emmie/placa_desarrollo_efm32/Placa ARM.kicad_pcb

## KiCad design Placa ARM.kicad_pcb (2020-09-28)

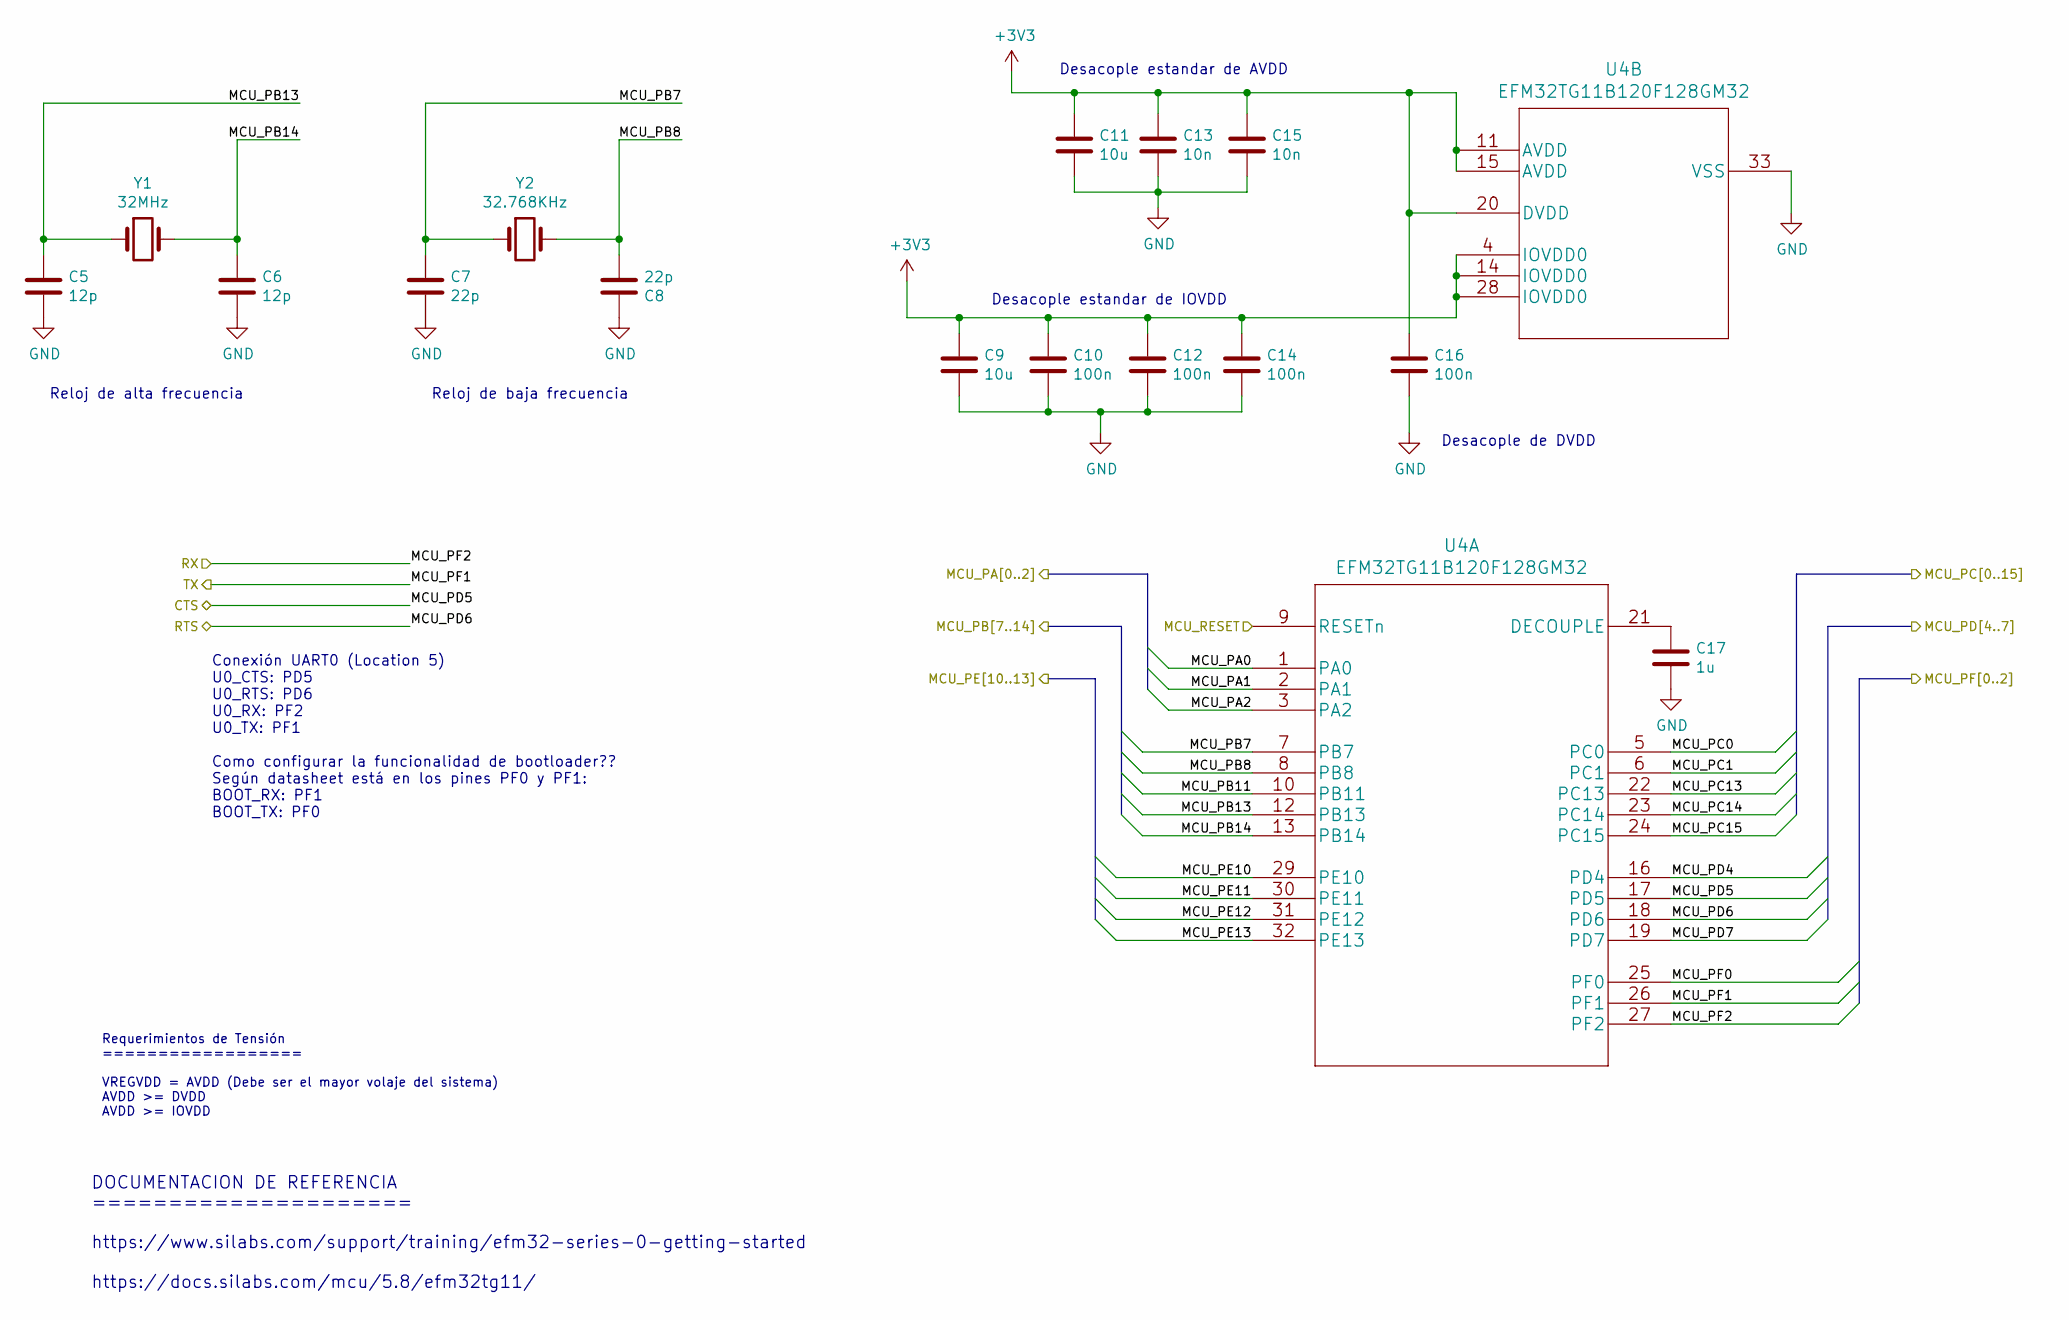
[picture p1: schematic Microcontrolador.sch, Placa de Desarrollo EFM32 - MCU ARM]

Parts:
C5, C6: 12p; C_0805_2012Metric_Pad1.15x1.40mm_HandSolder
C7, C8: 22p; C_0805_2012Metric_Pad1.15x1.40mm_HandSolder
C9, C11: 10u; C_1206_3216Metric_Pad1.42x1.75mm_HandSolder
C10, C12, C14, C16: 100n; C_1206_3216Metric_Pad1.42x1.75mm_HandSolder
C13, C15: 10n; C_1206_3216Metric_Pad1.42x1.75mm_HandSolder
C17: 1u; C_1206_3216Metric_Pad1.42x1.75mm_HandSolder
U4: EFM32TG11B120F128GM32
Y1: 32MHz; Crystal_SMD_ECS_CSM3X-2Pin_7.6x4.1mm
Y2: 32.768KHz; Crystal_AT310_D3.0mm_L10.0mm_Horizontal

Connections:
/IU5: U4.9 (RESETn); also elsewhere on the board
/IU6: U4.26 (PF1); also elsewhere on the board
/IU7: U4.27 (PF2); also elsewhere on the board
/IU8: U4.17 (PD5); also elsewhere on the board
/IU9: U4.18 (PD6); also elsewhere on the board
/Interfaz de Usuario/MCU_PA0: U4.1 (PA0); also elsewhere on the board
/Interfaz de Usuario/MCU_PA1: U4.2 (PA1); also elsewhere on the board
/Interfaz de Usuario/MCU_PA2: U4.3 (PA2); also elsewhere on the board
/Interfaz de Usuario/MCU_PB11: U4.10 (PB11); also elsewhere on the board
/Interfaz de Usuario/MCU_PC0: U4.5 (PC0); also elsewhere on the board
/Interfaz de Usuario/MCU_PC1: U4.6 (PC1); also elsewhere on the board
/Interfaz de Usuario/MCU_PC13: U4.22 (PC13); also elsewhere on the board
/Interfaz de Usuario/MCU_PC14: U4.23 (PC14); also elsewhere on the board
/Interfaz de Usuario/MCU_PC15: U4.24 (PC15); also elsewhere on the board
/Interfaz de Usuario/MCU_PD4: U4.16 (PD4); also elsewhere on the board
/Interfaz de Usuario/MCU_PD7: U4.19 (PD7); also elsewhere on the board
/Interfaz de Usuario/MCU_PE10: U4.29 (PE10); also elsewhere on the board
/Interfaz de Usuario/MCU_PE11: U4.30 (PE11); also elsewhere on the board
/Interfaz de Usuario/MCU_PE12: U4.31 (PE12); also elsewhere on the board
/Interfaz de Usuario/MCU_PE13: U4.32 (PE13); also elsewhere on the board
/Interfaz de Usuario/MCU_PF0: U4.25 (PF0); also elsewhere on the board
/Microcontrolador/MCU_PB7: C7.1, U4.7 (PB7), Y2.1
/Microcontrolador/MCU_PB13: C5.1, U4.12 (PB13), Y1.1
/Microcontrolador/MCU_PB14: C6.1, U4.13 (PB14), Y1.2
unnamed: C17.1, U4.21 (DECOUPLE)

Notes on the sheet:
Desacople estandar de AVDD
Desacople estandar de IOVDD
Reloj de baja frecuencia
Reloj de alta frecuencia
Desacople de DVDD
Conexión UART0 (Location 5) U0_CTS: PD5 U0_RTS: PD6 U0_RX: PF2 U0_TX: PF1 Como configurar la funcionalidad de bootloader?? Según datasheet está en los pines PF0 y PF1: BOOT_RX: PF1 BOOT_TX: PF0
Requerimientos de Tensión ================== VREGVDD = AVDD (Debe ser el mayor volaje del sistema) AVDD >= DVDD AVDD >= IOVDD
DOCUMENTACION DE REFERENCIA ===================== https://www.silabs.com/support/training/efm32-series-0-getting-started https://docs.silabs.com/mcu/5.8/efm32tg11/

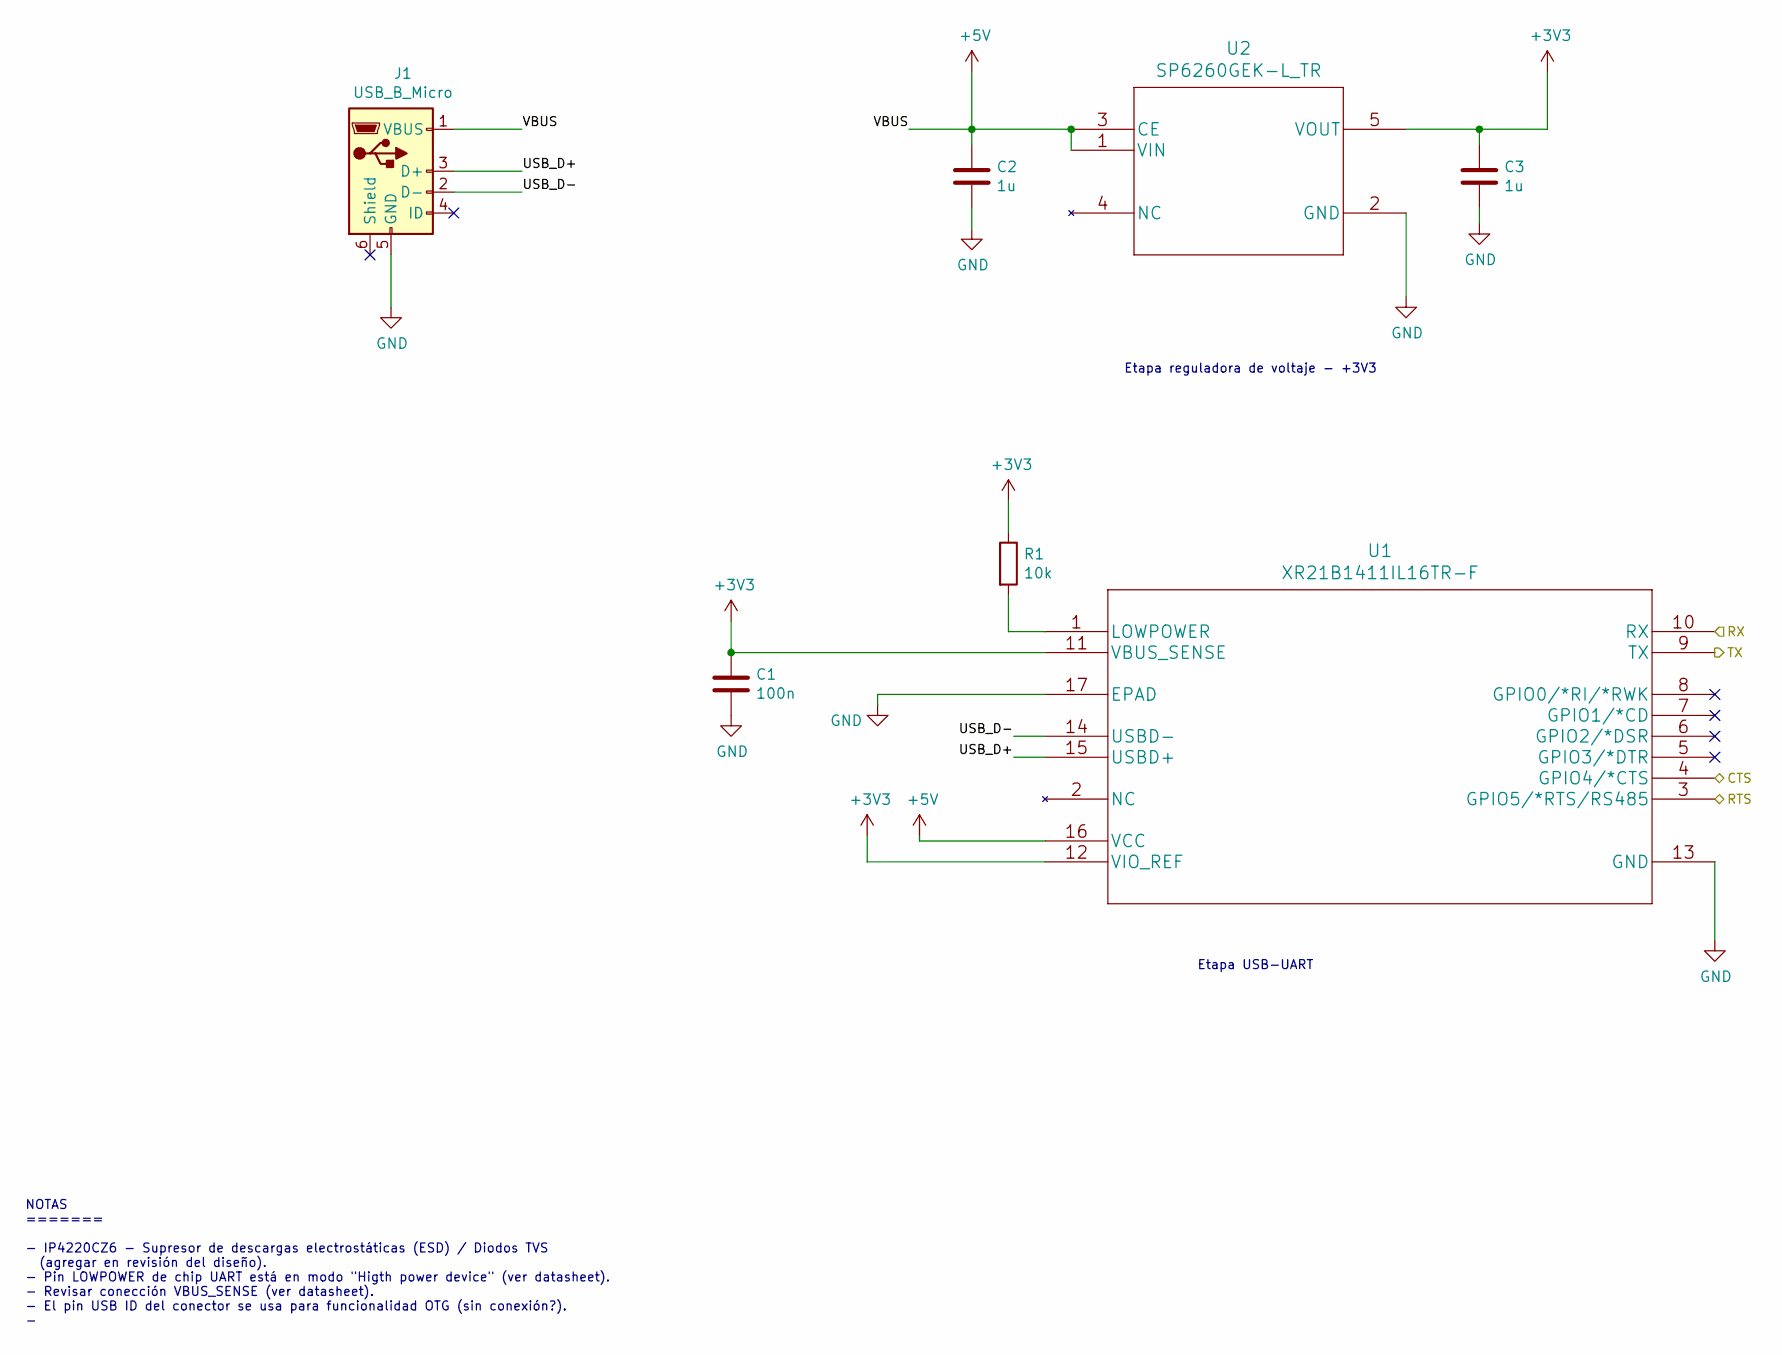
[picture p2: schematic Fuente de Poder.sch, Placa de Desarrollo EFM32 - MCU ARM]

Parts:
C1: 100n; C_1206_3216Metric_Pad1.42x1.75mm_HandSolder
C2, C3: 1u; C_1206_3216Metric_Pad1.42x1.75mm_HandSolder
J1: USB_B_Micro; USB_Micro-B_Molex_47346-0001
R1: 10k; R_1206_3216Metric_Pad1.42x1.75mm_HandSolder
U1: XR21B1411IL16TR-F
U2: SP6260GEK-L_TR; SP6260GEKLTR

Connections:
+5V: C2.1, J1.1 (VBUS), U1.16 (VCC), U2.1 (VIN), U2.3 (CE); also elsewhere on the board
/Fuente de Poder/USB_D+: J1.3 (D+), U1.15 (USBD+)
/Fuente de Poder/USB_D-: J1.2 (D-), U1.14 (USBD-)
/IU6: U1.10 (RX); also elsewhere on the board
/IU7: U1.9 (TX); also elsewhere on the board
/IU8: U1.4 (GPIO4/*CTS); also elsewhere on the board
/IU9: U1.3 (GPIO5/*RTS/RS485); also elsewhere on the board
unnamed: R1.2, U1.1 (LOWPOWER)

Notes on the sheet:
Etapa reguladora de voltaje - +3V3
NOTAS ======= - IP4220CZ6 - Supresor de descargas electrostáticas (ESD) / Diodos TVS (agregar en revisión del diseño). - Pin LOWPOWER de chip UART está en modo "Higth power device" (ver datasheet). - Revisar conección VBUS_SENSE (ver datasheet). - El pin USB ID del conector se usa para funcionalida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
Etapa USB-UART

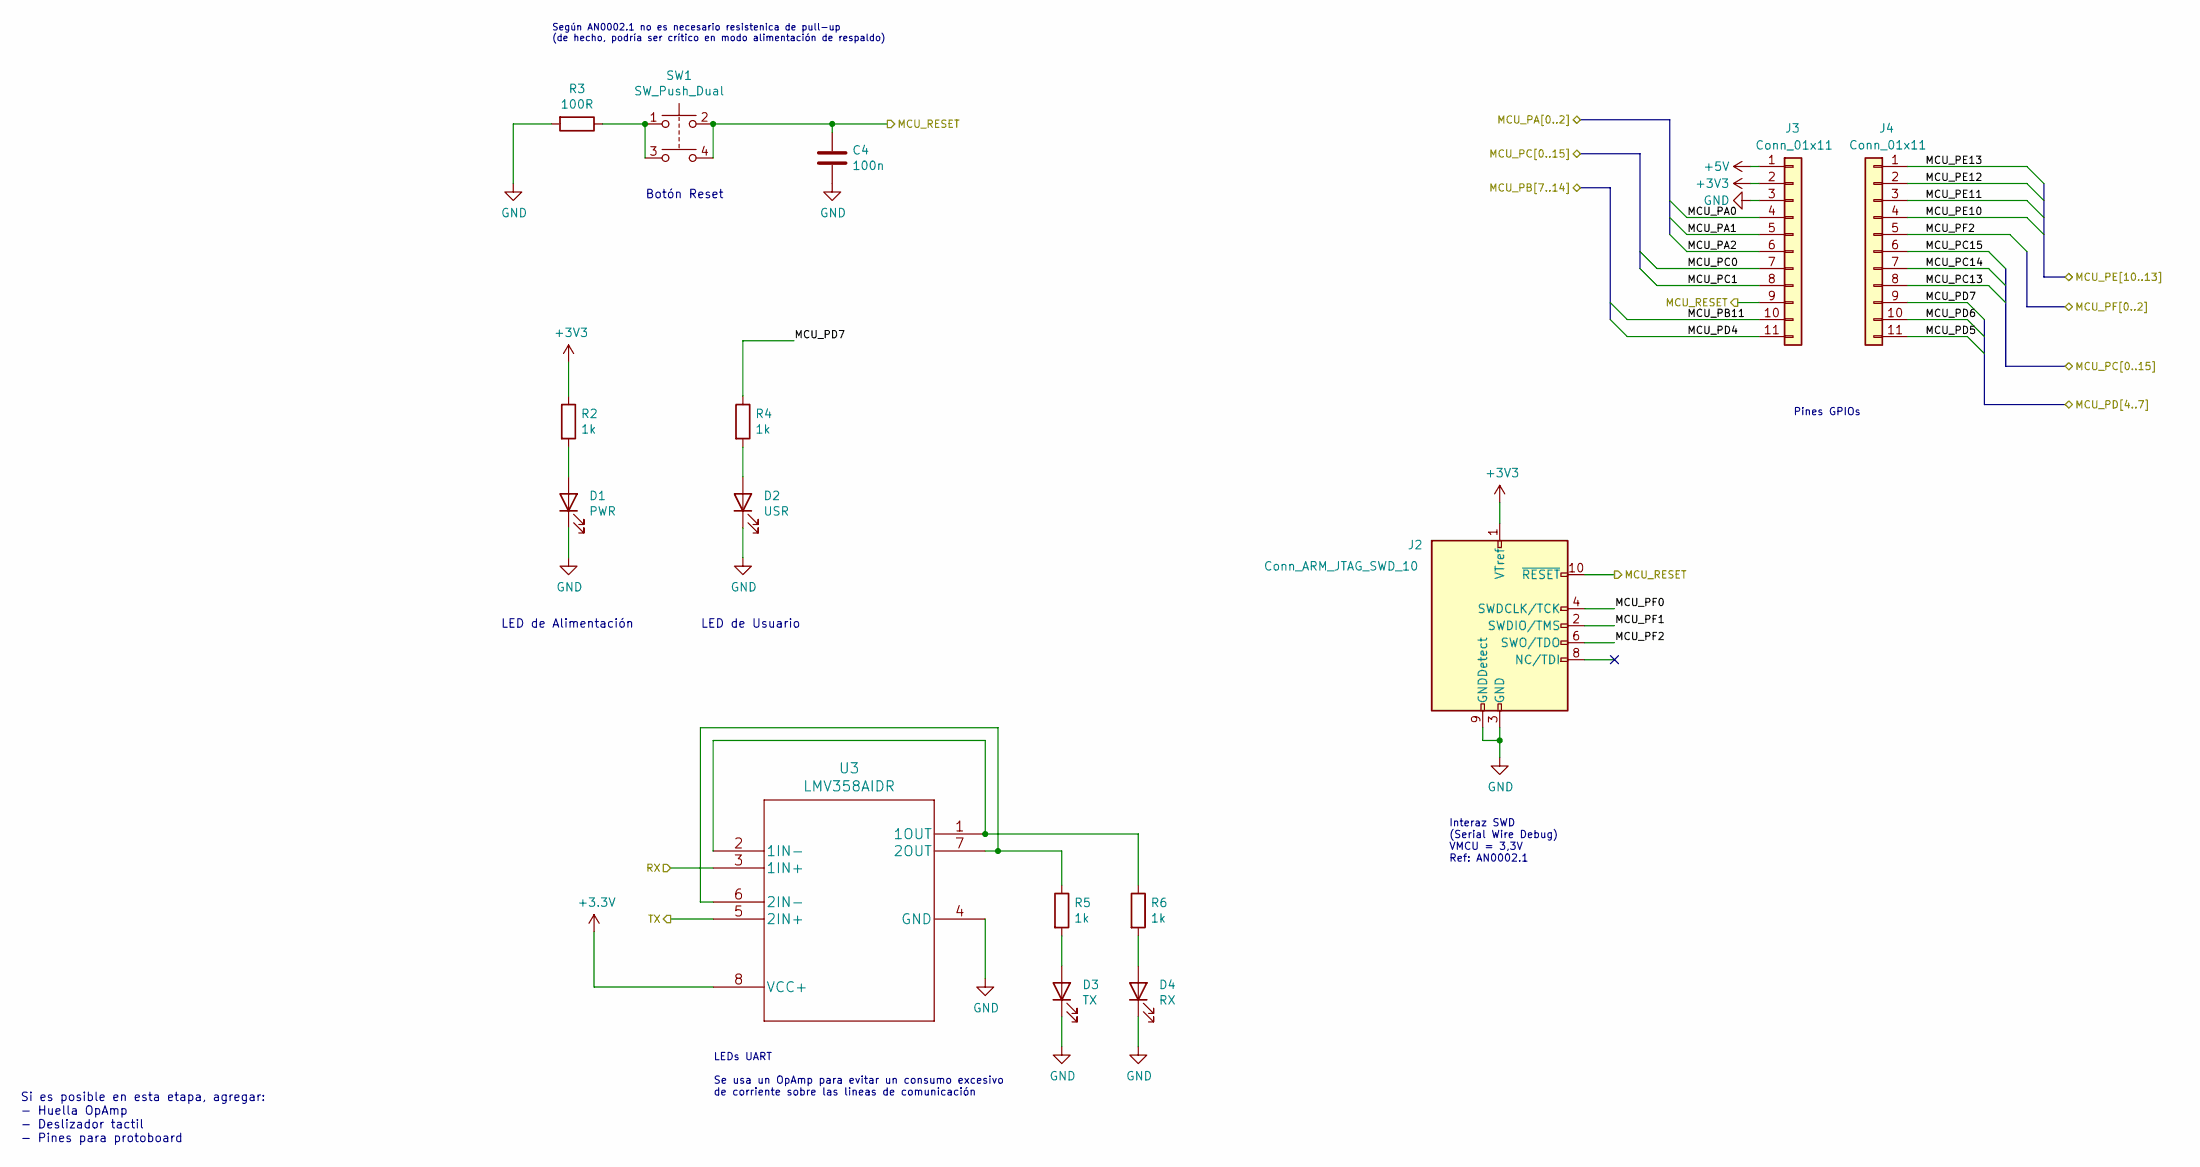
[picture p3: schematic Interfaz de Usuario.sch, Placa de Desarrollo EFM32 - MCU ARM]

Parts:
C4: 100n; C_1206_3216Metric_Pad1.42x1.75mm_HandSolder
D1: PWR; LED_1206_3216Metric
D2: USR; LED_1206_3216Metric
D3: TX; LED_1206_3216Metric
D4: RX; LED_1206_3216Metric
J2: Conn_ARM_JTAG_SWD_10; PinHeader_2x05_P1.00mm_Vertical_SMD
J3, J4: Conn_01x11; PinHeader_1x11_P2.54mm_Vertical
R2: 1k; R_1206_3216Metric_Pad1.42x1.75mm_HandSolder
R3: 100R; R_0603_1608Metric_Pad1.05x0.95mm_HandSolder
R4, R5, R6: 1k; R_0603_1608Metric_Pad1.05x0.95mm_HandSolder
SW1: SW_Push_Dual; SW_TH_Tactile_Omron_B3F-10xx
U3: LMV358AIDR

Connections:
+5V: J3.1; also elsewhere on the board
/IU5: C4.1, J2.10 (~RESET~), J3.9, SW1.2, SW1.4; also elsewhere on the board
/IU6: J2.2 (SWDIO/TMS), U3.3 (1IN+); also elsewhere on the board
/IU7: J2.6 (SWO/TDO), J4.5, U3.5 (2IN+); also elsewhere on the board
/IU8: J4.11; also elsewhere on the board
/IU9: J4.10; also elsewhere on the board
/Interfaz de Usuario/MCU_PA0: J3.4; also elsewhere on the board
/Interfaz de Usuario/MCU_PA1: J3.5; also elsewhere on the board
/Interfaz de Usuario/MCU_PA2: J3.6; also elsewhere on the board
/Interfaz de Usuario/MCU_PB11: J3.10; also elsewhere on the board
/Interfaz de Usuario/MCU_PC0: J3.7; also elsewhere on the board
/Interfaz de Usuario/MCU_PC1: J3.8; also elsewhere on the board
/Interfaz de Usuario/MCU_PC13: J4.8; also elsewhere on the board
/Interfaz de Usuario/MCU_PC14: J4.7; also elsewhere on the board
/Interfaz de Usuario/MCU_PC15: J4.6; also elsewhere on the board
/Interfaz de Usuario/MCU_PD4: J3.11; also elsewhere on the board
/Interfaz de Usuario/MCU_PD7: J4.9, R4.1; also elsewhere on the board
/Interfaz de Usuario/MCU_PE10: J4.4; also elsewhere on the board
/Interfaz de Usuario/MCU_PE11: J4.3; also elsewhere on the board
/Interfaz de Usuario/MCU_PE12: J4.2; also elsewhere on the board
/Interfaz de Usuario/MCU_PE13: J4.1; also elsewhere on the board
/Interfaz de Usuario/MCU_PF0: J2.4 (SWDCLK/TCK); also elsewhere on the board
unnamed: D1.2 (A), R2.2
unnamed: D2.2 (A), R4.2
unnamed: D3.2 (A), R5.2
unnamed: D4.2 (A), R6.2
unnamed: R3.1, SW1.1, SW1.3
unnamed: R5.1, U3.6 (2IN-), U3.7 (2OUT)
unnamed: R6.1, U3.1 (1OUT), U3.2 (1IN-)

Notes on the sheet:
LED de Usuario
Botón Reset
Si es posible en esta etapa, agregar: - Huella OpAmp - Deslizador tactil - Pines para protoboard
LED de Alimentación
Pines GPIOs
Según AN0002.1 no es necesario resistenica de pull-up (de hecho, podría ser crítico en modo alimentación de respaldo)
Interaz SWD (Serial Wire Debug) VMCU = 3,3V Ref: AN0002.1
LEDs UART Se usa un OpAmp para evitar un consumo excesivo de corriente sobre las lineas de comunicación

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
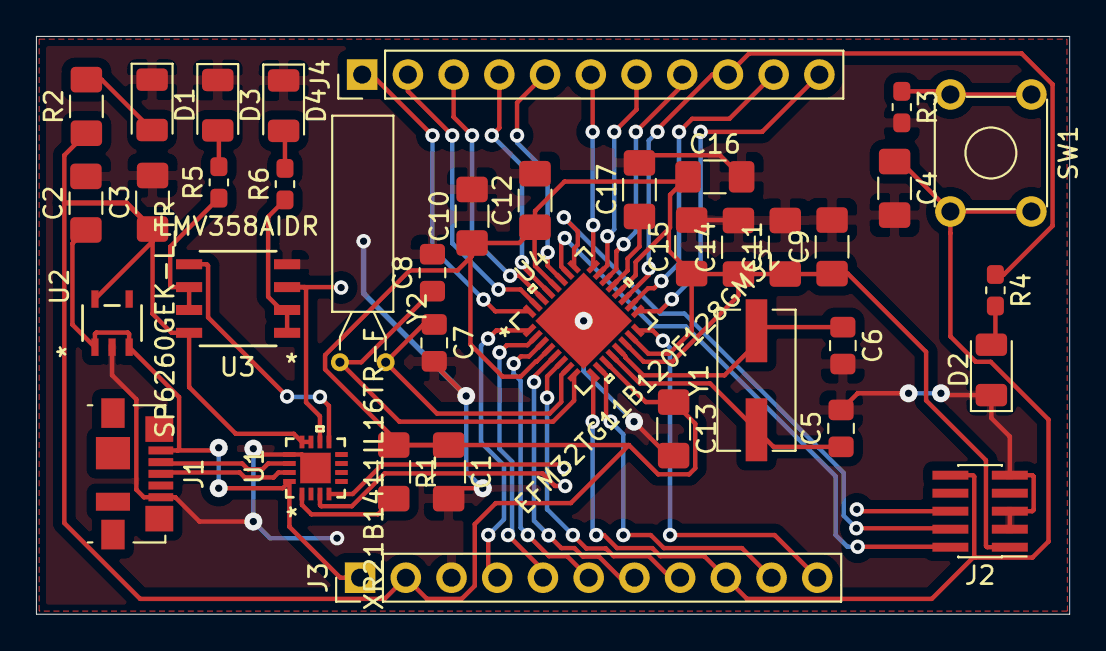
[picture p4: board Placa ARM.kicad_pcb from above]

Board: 2 copper layers, 57.4 x 32.1 mm, 38 parts (0 on the bottom side), 39 nets.
