emmie/placa_desarrollo_efm32/(commit log)

2020-09-04 Issue #1: Conexion inicial de componetes
    [Fuente de Poder.sch, Interfaz de Usuario.sch, Microcontrolador.sch, Placa ARM.kicad_pcb, Placa ARM.sch]
2020-09-05 Issue #1: Correción de las conexiones Bus
    [Fuente de Poder.sch, Interfaz de Usuario.sch, Microcontrolador.sch, Placa ARM.sch]
2020-09-11 Issue #1: Cambio de regulador de voltaje
    Se reemplazó el MAX8887 de Maxim por el SP6260 de Maxlinear.
    [Fuente de Poder.sch, Microcontrolador.sch]
2020-09-12 Issue #1: Cambio de conector USB-UART
    Se agrega un conector para todos los pines UART ofrecidos por el IC
    XR21B1411 de Maxlinear.
    [Interfaz de Usuario.sch, Microcontrolador.sch, Placa ARM.sch]
2020-09-15 Issue #1: Mejora de la funcionalidad de reset
    [Interfaz de Usuario.sch, Microcontrolador.sch]
2020-09-15 Issue #1: Cambio de conector GPIOs
    [Interfaz de Usuario.sch]
2020-09-15 Issue #1: Incorporación de conector para debug
    Se agrega el conector estandar para ARM de 10 pines para debug con SWD.
    Como referencia use la nota de aplicación AN0002.1
    [Fuente de Poder.sch, Interfaz de Usuario.sch, Microcontrolador.sch]
2020-09-15 Issue #1: Se agregan LEDs para líneas TX/RX de UART
    Se agregan los LEDs para indicar comunicación vía UART. Se utilizó un
    OpAmp para evitar un consumo excesivo de corriente en las líneas de
    comunicación.
    Referencia: https://bit.ly/2E7PuVE
    [Interfaz de Usuario.sch, Microcontrolador.sch]
2020-09-16 Issue #2: Primer acercamiento al diseño de la PCB
    Se modificaron los conectores externos de los pines GPIOs (para no
    exponer los que se conectan a los cristales) y se realizó la
    distribución inicial de componentes en la placa (sin conectarlos)
    [Fuente de Poder.sch, Interfaz de Usuario.sch, Microcontrolador.sch]
2020-09-28 Issue #2: PCB lista para primera prueba de concepto
    [Fuente de Poder.sch, Interfaz de Usuario.sch, Microcontrolador.sch, Placa ARM.kicad_pcb, Placa ARM.sch]
